erikstoklasa/MugHeater/3d_print/04_Top_Base.SLDPRT

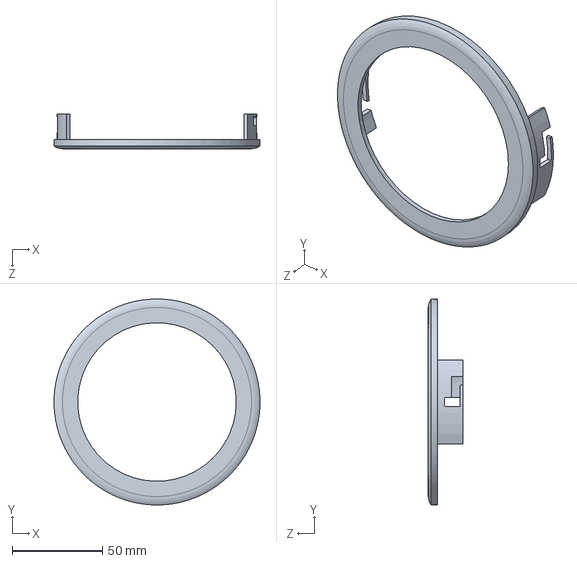
[picture p4: CAD file, 2025-01-01]
3d_print/04_Top_Base.SLDPRT
114.4 x 114.3 x 19.2 mm
