erikstoklasa/MugHeater/3d_print/05_Aluminum_Plate.SLDPRT

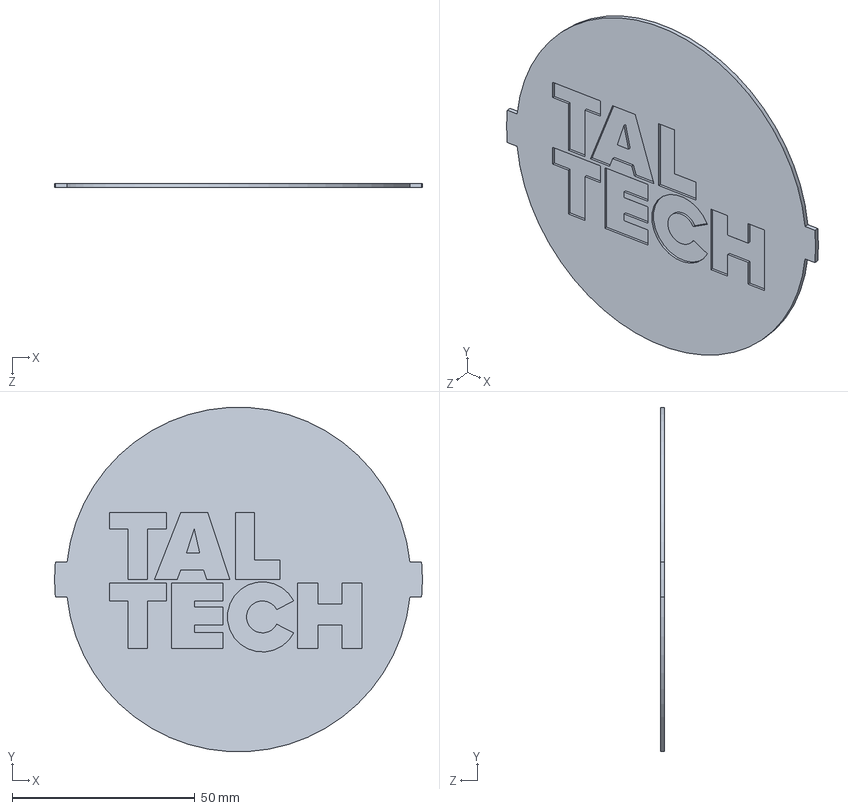
[picture p5: CAD file, 2025-01-01]
3d_print/05_Aluminum_Plate.SLDPRT
100.8 x 94.2 x 1.20 mm
