erikstoklasa/MugHeater/3d_print/02_Wire_Plate.SLDPRT

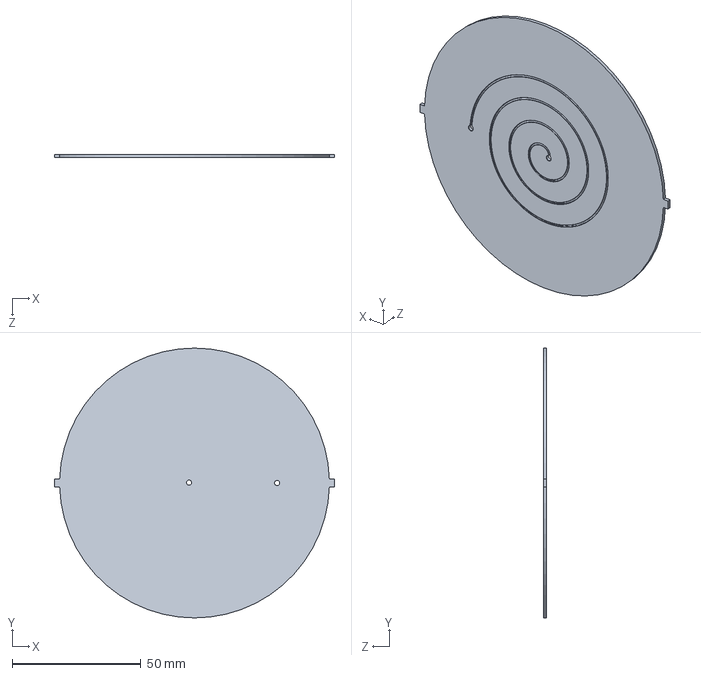
[picture p6: CAD file, 2025-01-01]
3d_print/02_Wire_Plate.SLDPRT
108.8 x 104.8 x 1.20 mm
