erikstoklasa/MugHeater/3d_print/03_Base.SLDPRT

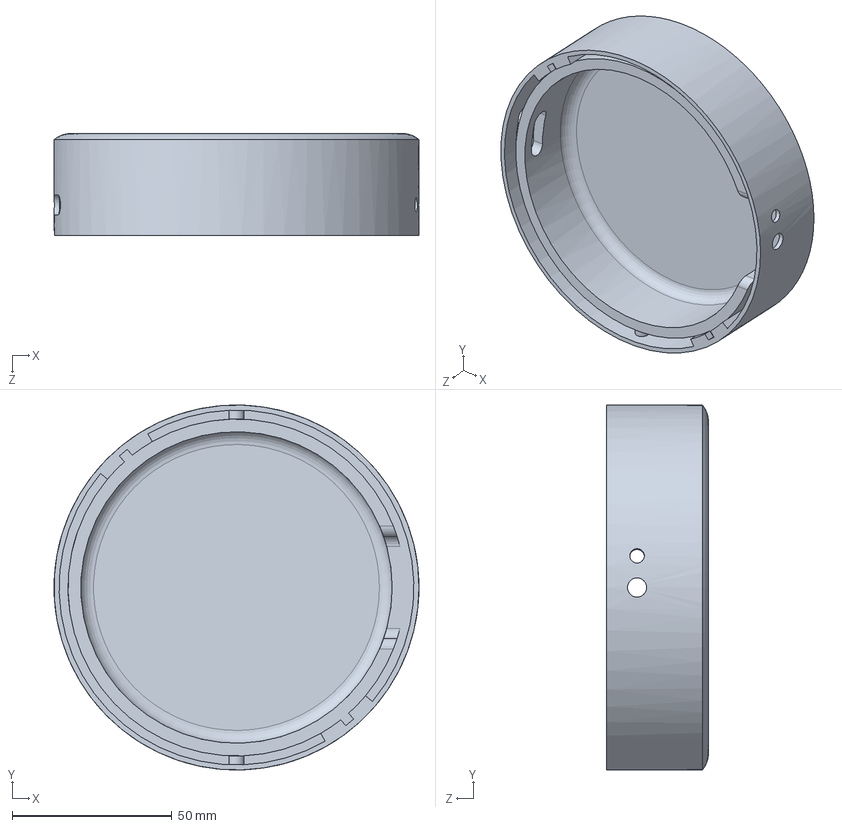
[picture p7: CAD file, 2025-01-01]
3d_print/03_Base.SLDPRT
114.4 x 114.4 x 32.0 mm
