erikstoklasa/MugHeater/(commit log)

2024-11-28 Project setup, ADC conversion
2024-12-07 Adding readme and schematic image
2025-01-01 Enhanced README with detailed project overview, system features, and setup instructions, adding 3d print files
    [02_Wire_Plate.SLDPRT, 03_Base.SLDPRT, 04_Top_Base.SLDPRT, 05_Aluminum_Plate.SLDPRT]
